KatherineZT/RSE-Probe-Bot/RSEApp/Button-blue.png

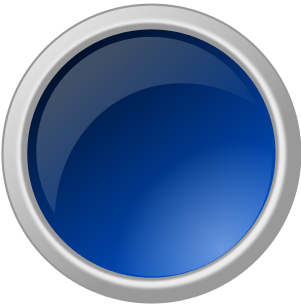
RSEApp/Button-blue.png
