KatherineZT/RSE-Probe-Bot/RSEApp/Button-grey.png

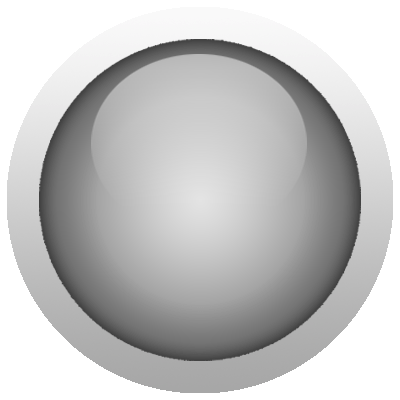
RSEApp/Button-grey.png
