KatherineZT/RSE-Probe-Bot/(commit log)

2020-01-14 project commit
    last version after ending of project in 2018, should be adjusted, view broken
    [Main.java]
2020-07-13 added arduinos code
2020-07-13 moved arduino files in folder
2020-07-14 arduino files places changed
